sshspb/grus/images/scheme1.pdf

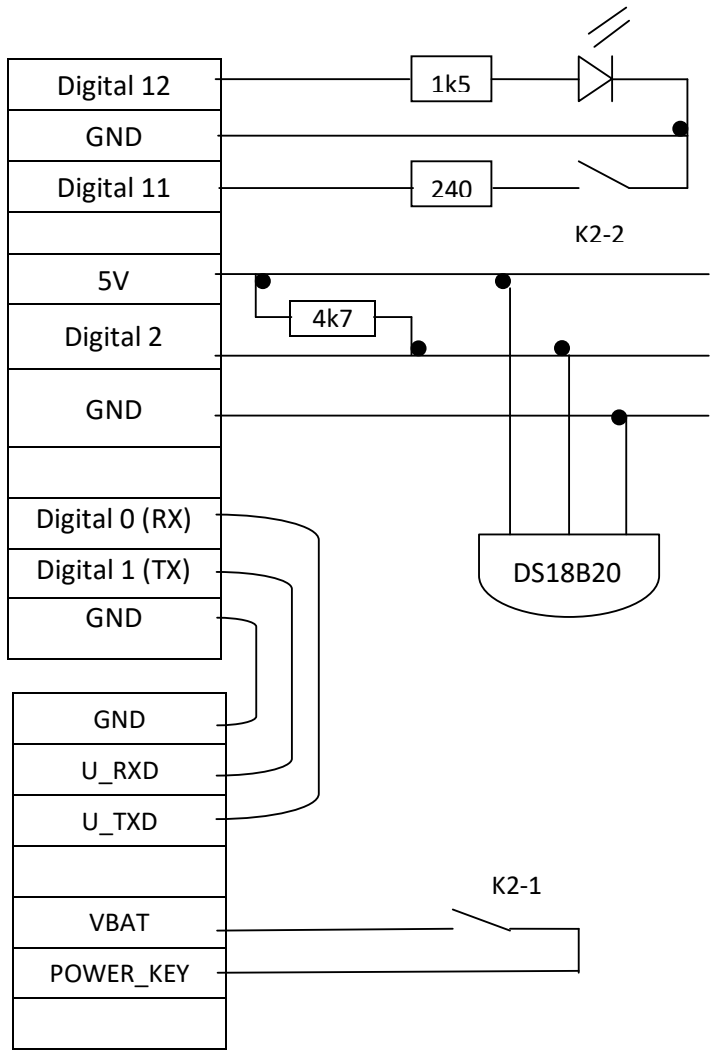
[picture p10: figure]
Digital 12; GND; Digital 11; Digital 2; Digital 0 (RX); Digital 1 (TX); U_RXD; U_TXD; VBAT; POWER_KEY

L7806CV
(L7808CV)

K1

+
10uF = 12V | = 6(8)V

### Arduino Uno

### A6 GSM/GPRS
