sshspb/grus/tools/ds18b20_adresses.cpp

#include <OneWire.h>
// OneWire DS18B20 Temperature Example
// http://www.pjrc.com/teensy/td_libs_OneWire.html

OneWire  ds(2);  // on pin 2 (a 4.7K resistor is necessary)

void setup(void) {
  Serial.begin(9600);
}

void loop(void) {
  byte i;
  byte present = 0;
  byte data[12];
  byte addr[8];
  float celsius;
  
  if ( !ds.search(addr)) {
    Serial.println("No more addresses.");
    Serial.println();
    ds.reset_search();
    delay(250);
    return;
  }
 
  ds.reset();
  ds.select(addr);
  ds.write(0x44);
  
  delay(1000);     // maybe 750ms is enough, maybe not
  
  present = ds.reset();
  ds.select(addr);    
  ds.write(0xBE);         // Read Scratchpad

  Serial.print("  Data = ");
  Serial.print(present, HEX);
  Serial.print(" ");
  for ( i = 0; i < 9; i++) {           // we need 9 bytes
    data[i] = ds.read();
    Serial.print(data[i], HEX);
    Serial.print(" ");
  }
  Serial.print(" CRC=");
  Serial.print(OneWire::crc8(data, 8), HEX);
  Serial.println();

  // Convert the data to actual temperature
  // because the result is a 16 bit signed integer, it should
  // be stored to an "int16_t" type, which is always 16 bits
  // even when compiled on a 32 bit processor.
  int16_t raw = (data[1] << 8) | data[0];
  celsius = (float)raw / 16.0;
  Serial.print("  Temperature = ");
  Serial.print(celsius);
  Serial.println(" Celsius, ");
  
  delay(1000);
}
