sshspb/grus/(commit log)

2018-11-08 description of toggle switches
2018-11-08 description of pined cable
2018-11-24 unstable enters the mode
    [grus.ino]
